ttahsin-bey/index/docs/electrical/flash-mobo/images/linux_lsusb.png

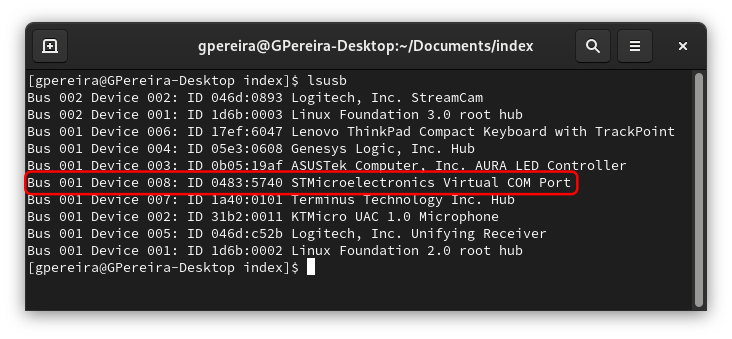
docs/electrical/flash-mobo/images/linux_lsusb.png
