ttahsin-bey/index/docs/electrical/flash-mobo/images/vscode_marlin_env.png

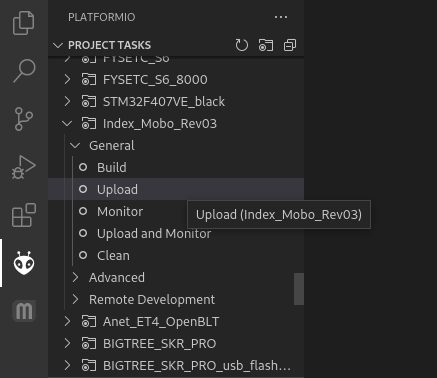
docs/electrical/flash-mobo/images/vscode_marlin_env.png
