ttahsin-bey/index/pnp/cad/Assemblies/left-side.FCStd

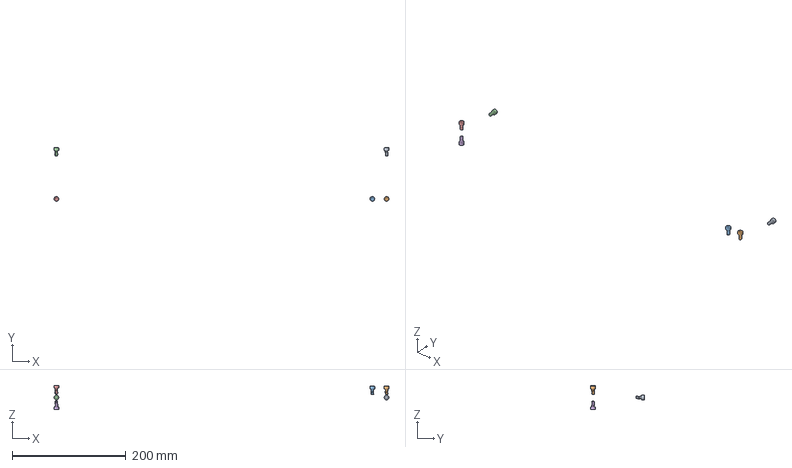
[picture p3: CAD file, 2021-07-05]
pnp/cad/Assemblies/left-side.FCStd
588.5 x 94.3 x 43.0 mm
M5x10-Screw
M5x10-Screw012
M5x10-Screw013
M5x10-Screw014
M5x10-Screw015
M5x10-Screw016
