ttahsin-bey/index/pnp/cad/FDM/FDM-0001_front-left-leg.FCStd

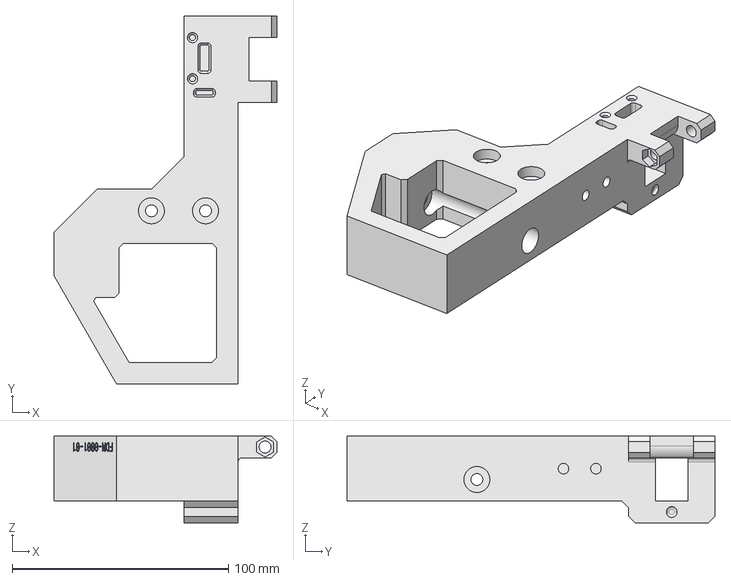
[picture p4: CAD file, 2021-07-05]
pnp/cad/FDM/FDM-0001_front-left-leg.FCStd
103.0 x 170.0 x 40.0 mm
