ttahsin-bey/index/pnp/cad/OTS/OTS-0004-00_extrusion.FCStd

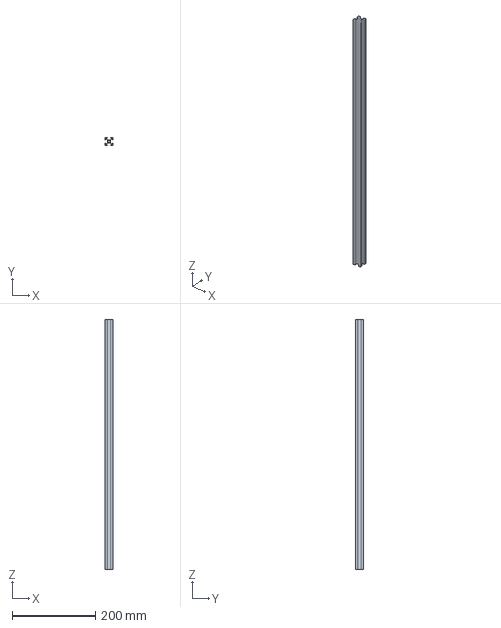
[picture p5: CAD file, 2021-07-05]
pnp/cad/OTS/OTS-0004-00_extrusion.FCStd
20.0 x 20.0 x 600.0 mm
