ttahsin-bey/index/pnp/cad/FDM/FDM-0003_back-left-leg.FCStd

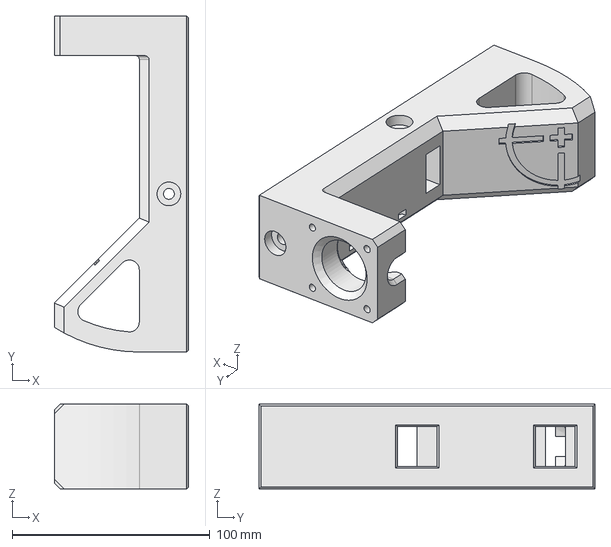
[picture p6: CAD file, 2021-07-05]
pnp/cad/FDM/FDM-0003_back-left-leg.FCStd
68.0 x 170.0 x 43.0 mm
