ttahsin-bey/index/pnp/cad/OTS/OTS-0005-00_t-slot-nut.FCStd

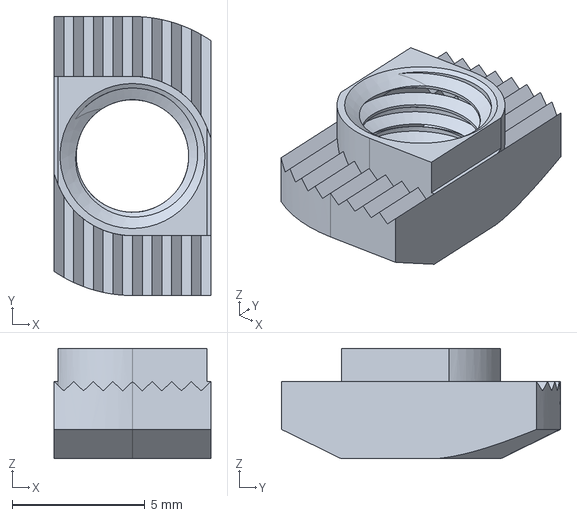
[picture p7: CAD file, 2021-07-05]
pnp/cad/OTS/OTS-0005-00_t-slot-nut.FCStd
5.90 x 10.5 x 4.15 mm
