ttahsin-bey/index/docs/mechanical-assembly/index.html

Edit this page (https://github.com/index-machines/index/edit/master/doc/content/en/docs/mechanical-assembly/_index.md) Create child page (https://github.com/index-machines/index/new/master/doc/content/en/docs/mechanical-assembly/_index.md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) Create documentation issue (https://github.com/index-machines/index/issues/new?title=Mechanical%20Assembly) Print entire section (https://docs.indexmachines.io/docs/mechanical-assembly/_print/)

# Mechanical Assembly

Assembling the frame of the Index PNP

## What you’ll need

### Parts

#### Caution

The project is under active development and not all materials will be in sync. Please ensure that you’ve done some research to ensure you select the appropriate model, BOM, hardware, firmware and software combination.

To build your own index you will need to acquire the items listed on the BOM (https://github.com/index-machines/index/blob/master/pnp/INDEX%20BOM%20-%20MECH.csv). This includes various mechanical components along with a significant number of 3D printed parts (https://github.com/index-machines/index/tree/master/pnp/cad/3D-Prints). When printing the 3d parts, be sure to print them with the recommended settings.

### Tools

The following tools are needed to build the Index.

- 2mm Allen Key
- 2.5mm Allen Key
- 3mm Allen Key
- 4mm Allen Key
- Fine Tip Tweezers (for positioning T-Nuts)
- Pliers / Vice Grips
- Utility Knife / Precision Blade

### Tips & Tricks

When assembling the Index, the following tips will help the process go more smoothly.

- Clean up your 3D prints well. Make sure that you have removed any support material, and have cleaned up the edges of any holes. Test that you can fit the V-Slot or machine screw for a specific part into the hole.
- Deburr the aluminum profile at the ends. Then it’s easier to put parts together.
- Slot Nuts come in two different formats. One form can be inserted into the slot through the slot. The other form must be inserted from the end. Watch for notes in the about when to insert based on which type you’re using.
- Positioning Slot Nuts can be a bit of a challenge. A simple way to get them into the right place is to use gravity to get them close, and then use either the long end an allen key or a pair of fine tipped tweezers to push or pull them to the exact position.
- Inserting Belts can be easier if you move the gantry you’re inserting the belt into to the middle of the rail it is on and then as you insert the belt, move it away from the side you want the belt to come out from. The v-slot will catch the belt and once you’ve moved the gantry a little bit, you will be able to catch the belt. Passing a belt through a belt slot from the inner side can be easier if you place an exacto knife blade at the back side of the slot and butt the belt against that while drawing it up through the slot.
- Press Fit Nuts are used in several places. If your printer tolerances make it so these nuts don’t stay in you can use a piece of tape over the back to hold them in temporarily.

##### Left Side

The left side provides the rails on which the Y gantry runs. In addition, most of the cables are routed to the front left of the machine as that is where the controller ultimately lives.

##### Right Side

Assembly instructions for the right side of the frame.

##### Staging Plate

Assembly of the staging plate.

##### Frame Assembly

The Left and Right side assemblies that were completed in the previous steps are next connected together by two 600mm v-slot extrusions.

##### X Idler Mount

Assembly for the X Idler Mount

##### X Motor Mount

Assembly for the X Motor Mount

##### Y Gantry

Assembly for the Y Gantry

##### Y Gantry Motion

Motion Setup for the Y Gantry

##### X Gantry

X Gantry Assembly

##### Tool Assembly

In this step you will assemble the tools you desire for your Index build.

Last modified July 3, 2021: Remove note pointing to closed issues. (e4beabb6) (https://github.com/index-machines/index/commit/e4beabb61fa5bfc7a20099cb17fd1b1b745ba1d2)

- (https://twitter.com/stephentherobot)
- (https://www.instagram.com/stephentherobot/)
- (https://github.com/index-machines/index)
- (https://discordapp.com/invite/TCwy6De)
