ttahsin-bey/index/docs/mechanical-assembly/staging-plate/index.html

Edit this page (https://github.com/index-machines/index/edit/master/doc/content/en/docs/mechanical-assembly/staging-plate/index.md) Create child page (https://github.com/index-machines/index/new/master/doc/content/en/docs/mechanical-assembly/staging-plate/index.md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) Create documentation issue (https://github.com/index-machines/index/issues/new?title=Staging%20Plate) Print entire section (https://docs.indexmachines.io/docs/mechanical-assembly/_print/)

# Staging Plate

Assembly of the staging plate.

The staging plate is a part which can be sourced locally or via the Index Machines Shop (https://shop.indexmachines.io/).

If you choose to build your own staging plate, please refer to the CSM-0001_staging-plate.FCStd (https://github.com/index-machines/index/blob/master/pnp/cad/CSM/CSM-0001_staging-plate.FCStd) file.

The plate is assumed to be 3mm thick steel in the standard index design. While it is possible to build the plate out of materials such as plastic or wood, the thickness of these materials will need to be adjusted to ensure the staging plate does not sag or flex.

Last modified July 3, 2021: Updates to include build details up to the frame assembly for the latest revision of the frame. (8e7a213b) (https://github.com/index-machines/index/commit/8e7a213bdccb7502d67ebce67a3f49c8498273ba)

- (https://twitter.com/stephentherobot)
- (https://www.instagram.com/stephentherobot/)
- (https://github.com/index-machines/index)
- (https://discordapp.com/invite/TCwy6De)
