ttahsin-bey/index/docs/mechanical-assembly/tool-assembly/index.html

Edit this page (https://github.com/index-machines/index/edit/master/doc/content/en/docs/mechanical-assembly/tool-assembly/index.md) Create child page (https://github.com/index-machines/index/new/master/doc/content/en/docs/mechanical-assembly/tool-assembly/index.md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) Create documentation issue (https://github.com/index-machines/index/issues/new?title=Tool%20Assembly) Print entire section (https://docs.indexmachines.io/docs/mechanical-assembly/_print/)

# Tool Assembly

In this step you will assemble the tools you desire for your Index build.

At the moment we support two sets of tools: A Placement Head and a Paste Dispensing Head (coming soon).

## Necessary Components

- Placement Head:
- 1x NEMA11 Motor
- 4x M2.5x8mm Screws
- 1x Pneumatic Fitting (6mm OD Tube and M5 Thread)
- 1x CP40 Nozzle Holder

## Assembly

Depending on the tools you intend to have on your Index, follow the appropriate instructions below.

### Placement head

1. Attach the Pneumatic fitting and the CP40 Nozzle Holder to the NEMA11 motor
2. Use four M2.5x8mm screws to attach the NEMA11 Motor with the shaft facing down.

Last modified February 21, 2021: Updates to build a working site using the docsy theme for hugo. This also builds and deploys the site using github actions, but will need updates to only do so on certain commits. (15b6057d) (https://github.com/index-machines/index/commit/15b6057d7357a41de0cf33c248cbd10214f78162)

- (https://twitter.com/stephentherobot)
- (https://www.instagram.com/stephentherobot/)
- (https://github.com/index-machines/index)
- (https://discordapp.com/invite/TCwy6De)
