ttahsin-bey/index/docs/mechanical-assembly/x-motor-mount/index.html

Edit this page (https://github.com/index-machines/index/edit/master/doc/content/en/docs/mechanical-assembly/x-motor-mount/index.md) Create child page (https://github.com/index-machines/index/new/master/doc/content/en/docs/mechanical-assembly/x-motor-mount/index.md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) Create documentation issue (https://github.com/index-machines/index/issues/new?title=X%20Motor%20Mount) Print entire section (https://docs.indexmachines.io/docs/mechanical-assembly/_print/)

# X Motor Mount

Assembly for the X Motor Mount

## Necessary Components & Tools

Collect the necessary items to complete the X motor mount. These are:

- 1x X Motor Mount (FDM-0006-00_x-motor-mount)
- 1x NEMA 17 Stepper Motor
- 1x GT2 Drive Pulley (5mm Bore, 20 teeth, 6mm belt width)
- 4x M3x12mm Machine Screw
- 2 mm Allen Key or Hex Screwdriver
- 2.5mm Allen Key or Hex Screwdriver



## Assembly

1. Install the GT2 pulley onto the motor shaft. The set screw side of the pulley should be nearest the motor. Tighten the set screws to lock the pulley into place. It should be at the tip of the shaft.



2. Place the motor onto the X motor mount with the wires exiting the motor on the left side of the bracket.



3. Insert a M3x12mm machine screw into each of the 4 holes in the bracket and tighten to secure the motor to the mount.



Last modified May 1, 2021: Adding links to the generated FDM part previews. (5f36e718) (https://github.com/index-machines/index/commit/5f36e71800ec29902947d070c3111e43d86ae6c9)

- (https://twitter.com/stephentherobot)
- (https://www.instagram.com/stephentherobot/)
- (https://github.com/index-machines/index)
- (https://discordapp.com/invite/TCwy6De)
