ttahsin-bey/index/docs/openpnp-setup/index.html

Edit this page (https://github.com/index-machines/index/edit/master/doc/content/en/docs/openpnp-setup/_index.md) Create child page (https://github.com/index-machines/index/new/master/doc/content/en/docs/openpnp-setup/_index.md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) Create documentation issue (https://github.com/index-machines/index/issues/new?title=OpenPNP%20Setup) Print entire section (https://docs.indexmachines.io/docs/openpnp-setup/_print/)

# OpenPNP Setup

Connect your Index to OpenPNP and configure it.

## What you’ll build

This tutorial will take you through the process of configuring OpenPNP to work with your Index PNP machine.

## What you’ll learn

- How to connect Index to OpenPNP

This guide is focused on assembling an Index and getting to being able to run your first job. Certain configuration details may be glossed over and simply provided to copy and paste.

## What you’ll need

An Index PNP with the mechanical and electrical build completed.

##### Installation

Install the OpenPNP software onto your machine.

Last modified March 28, 2021: refactor: Updates weight of OpenPNP setup page (bdb6bfd9) (https://github.com/index-machines/index/commit/bdb6bfd9b4aae5ac7c7fb0c9b2e2cffee6cba505)

- (https://twitter.com/stephentherobot)
- (https://www.instagram.com/stephentherobot/)
- (https://github.com/index-machines/index)
- (https://discordapp.com/invite/TCwy6De)
