ttahsin-bey/index/(commit log)

2021-07-05 Added frame side assembly
    [FDM-0001_front-left-leg.FCStd, FDM-0003_back-left-leg.FCStd, OTS-0004-00_extrusion.FCStd, OTS-0005-00_t-slot-nut.FCStd, left-side.FCStd]
2021-07-05 CI: Generate 3D Prints
